moderniselife/deskling/case/renders/back_3q.png

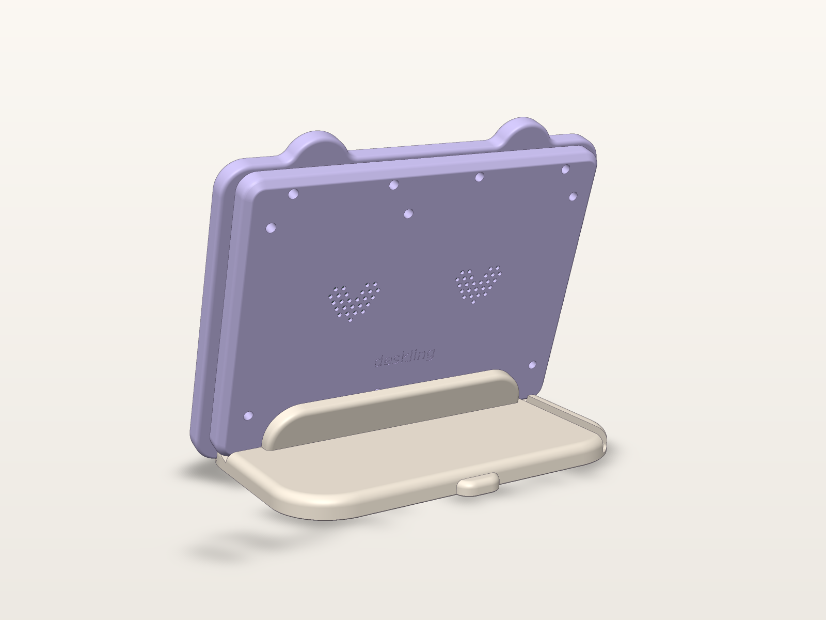
case/renders/back_3q.png
