moderniselife/deskling/case/renders/front.png

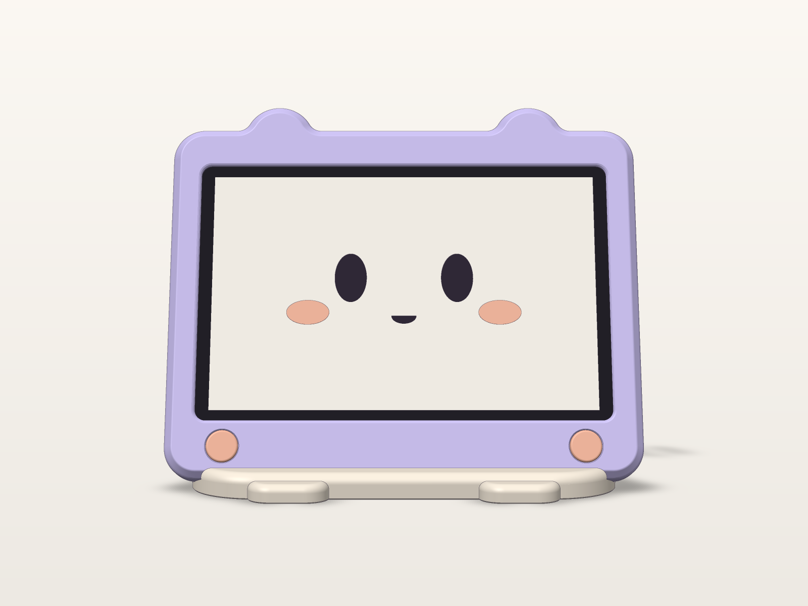
case/renders/front.png
