moderniselife/deskling/case/renders/section_side.png

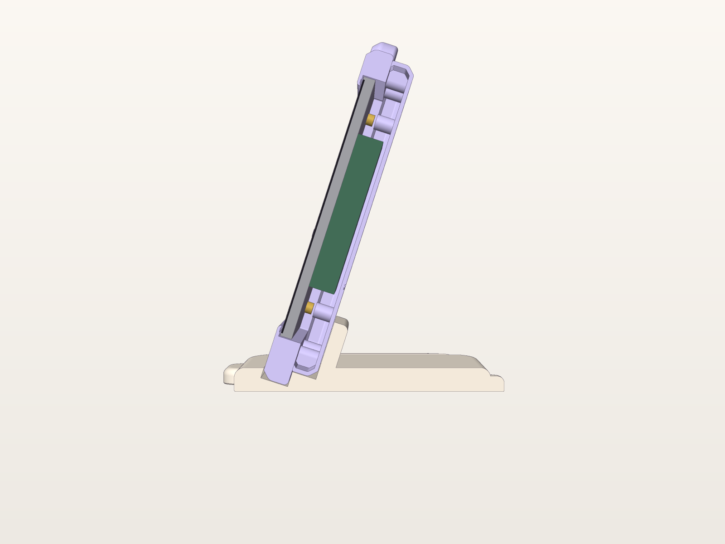
case/renders/section_side.png
