moderniselife/deskling/case/renders/stand.png

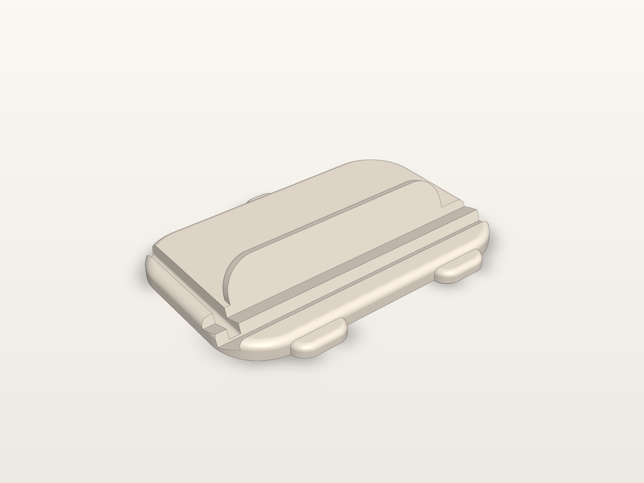
case/renders/stand.png
