moderniselife/deskling/case/renders/stand_underside.png

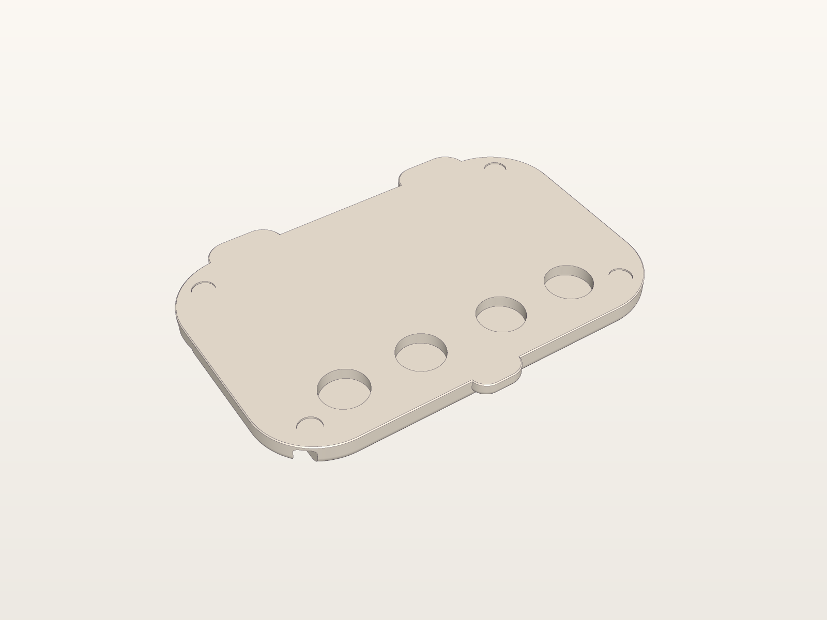
case/renders/stand_underside.png
