moderniselife/deskling/docs/media/home_done.gif

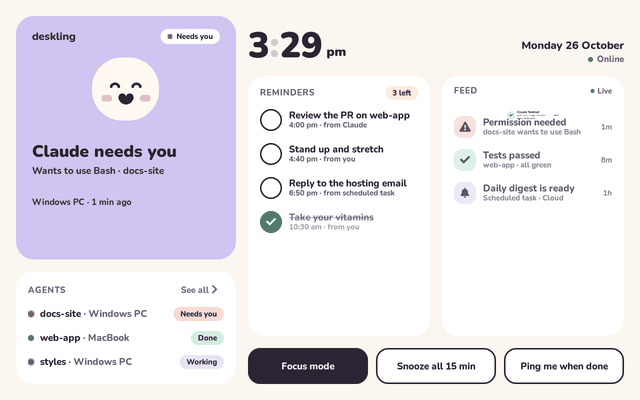
docs/media/home_done.gif
