moderniselife/deskling/docs/media/reminder.png

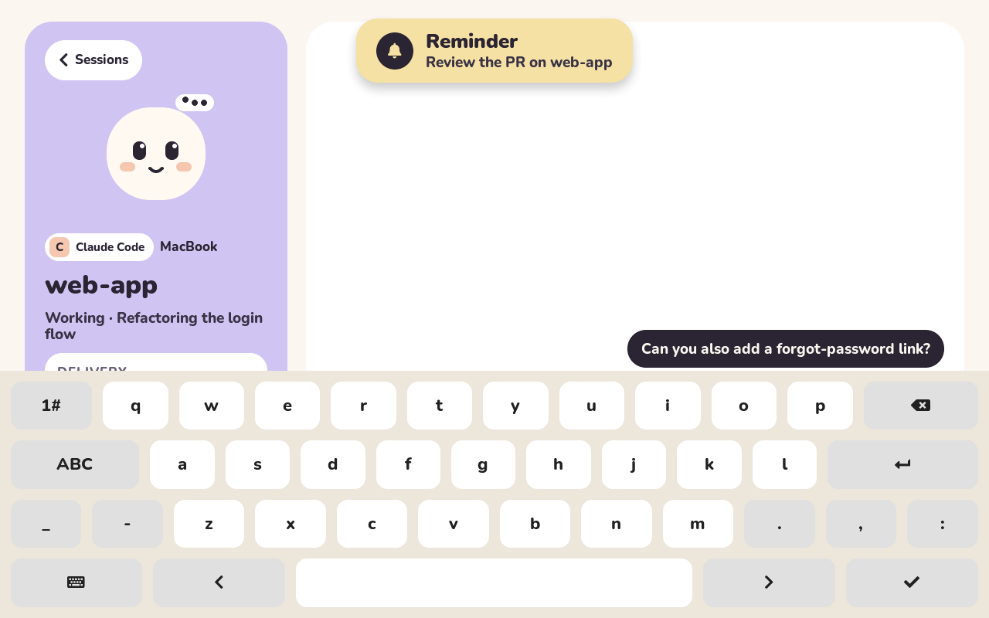
docs/media/reminder.png
