moderniselife/deskling/case/step/deskling_assembly.step

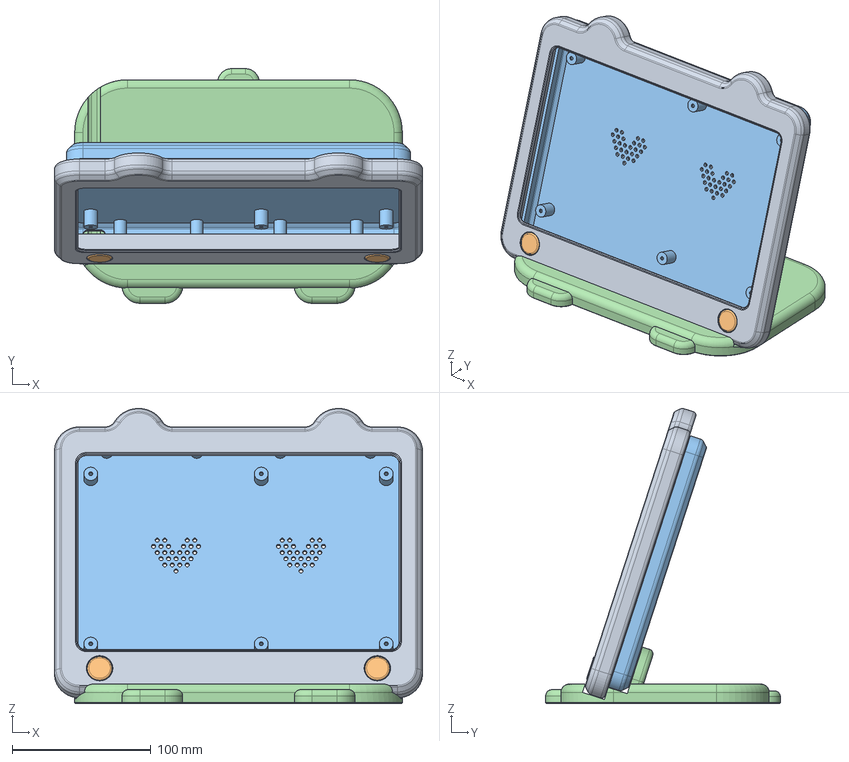
[picture p22: CAD file, 2026-10-26]
case/step/deskling_assembly.step
265.0 x 169.0 x 212.5 mm
