moderniselife/deskling/case/step/stand.step

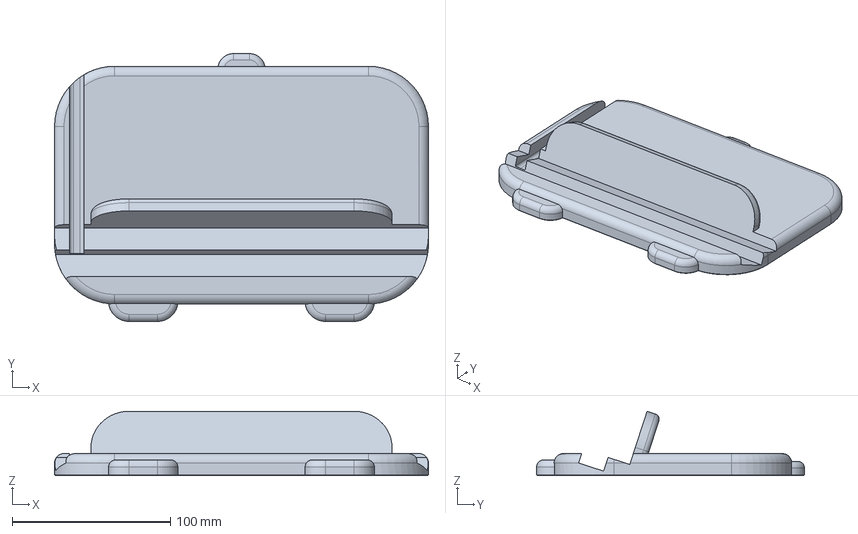
[picture p23: CAD file, 2026-10-26]
case/step/stand.step
236.0 x 169.0 x 40.7 mm
