moderniselife/deskling/case/step/bezel_right.step

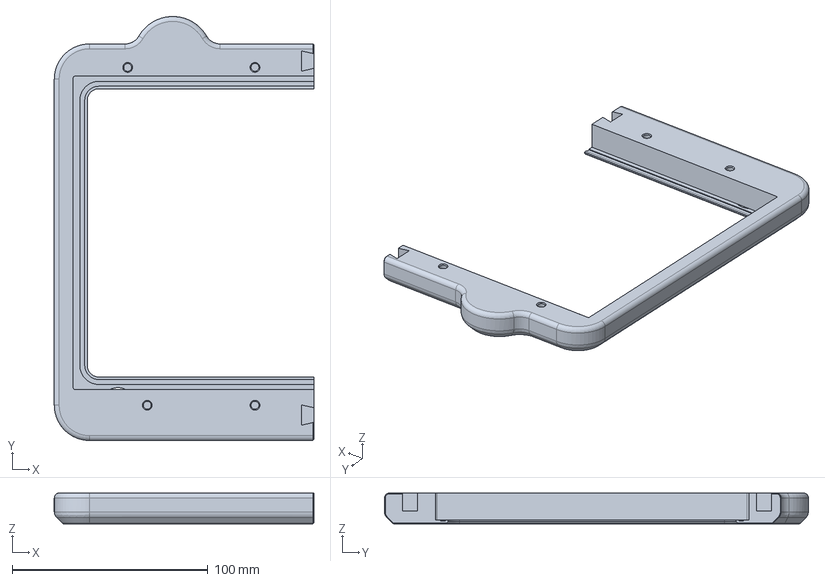
[picture p24: CAD file, 2026-10-26]
case/step/bezel_right.step
132.5 x 216.5 x 15.8 mm
