moderniselife/deskling/case/step/bezel_left.step

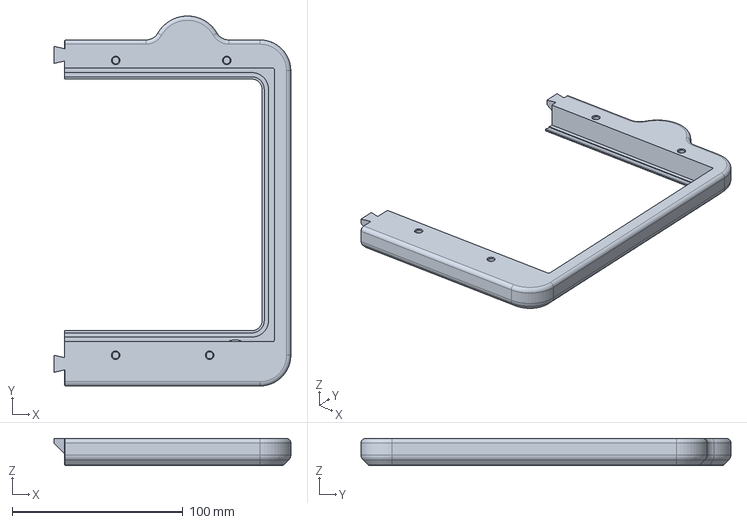
[picture p25: CAD file, 2026-10-26]
case/step/bezel_left.step
138.5 x 216.5 x 15.8 mm
