moderniselife/deskling/case/step/cheek_insert.step

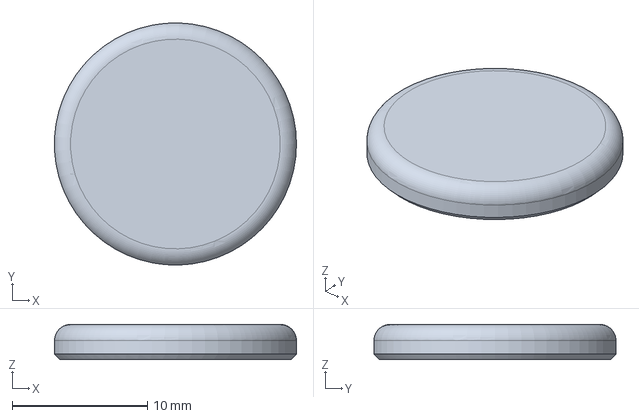
[picture p26: CAD file, 2026-10-26]
case/step/cheek_insert.step
17.9 x 17.9 x 2.60 mm
