moderniselife/deskling/case/step/bezel_onepiece.step

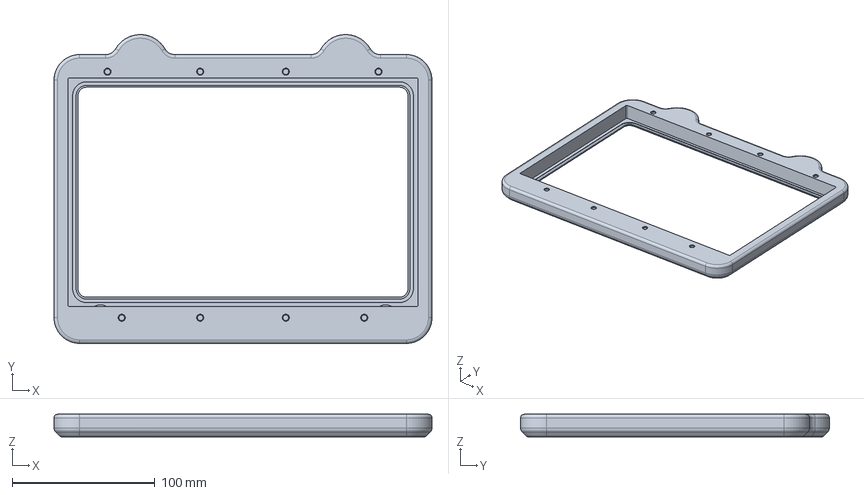
[picture p27: CAD file, 2026-10-26]
case/step/bezel_onepiece.step
265.0 x 216.5 x 15.8 mm
