moderniselife/deskling/case/step/back_cover.step

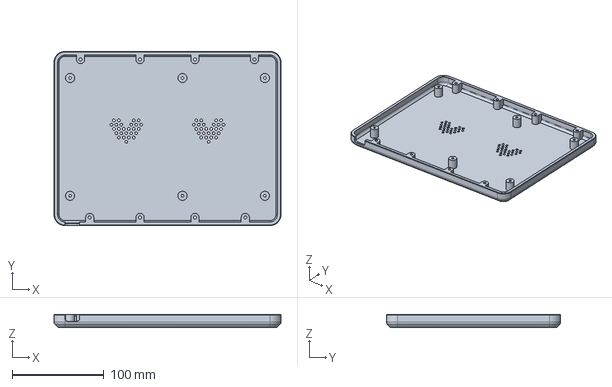
[picture p28: CAD file, 2026-10-26]
case/step/back_cover.step
248.0 x 190.3 x 14.4 mm
