moderniselife/deskling/case/step/fit_test_template.step

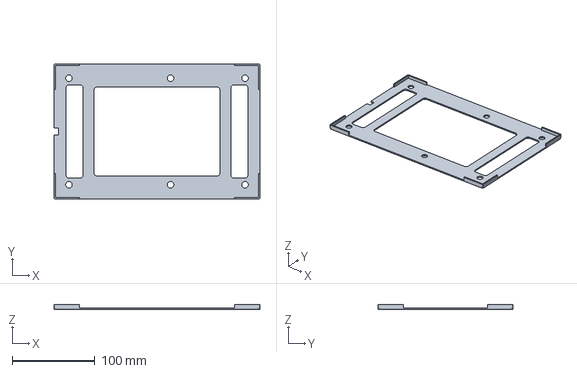
[picture p29: CAD file, 2026-10-26]
case/step/fit_test_template.step
248.8 x 163.2 x 6.00 mm
