moderniselife/deskling/(list of files, cad)

Other CAD files:
case/stl/back_cover.stl
case/stl/bezel_left.stl
case/stl/bezel_onepiece.stl
case/stl/bezel_right.stl
case/stl/cheek_insert.stl
case/stl/fit_test_template.stl
case/stl/stand.stl
