moderniselife/deskling/case/renders/bezel_split_print.png

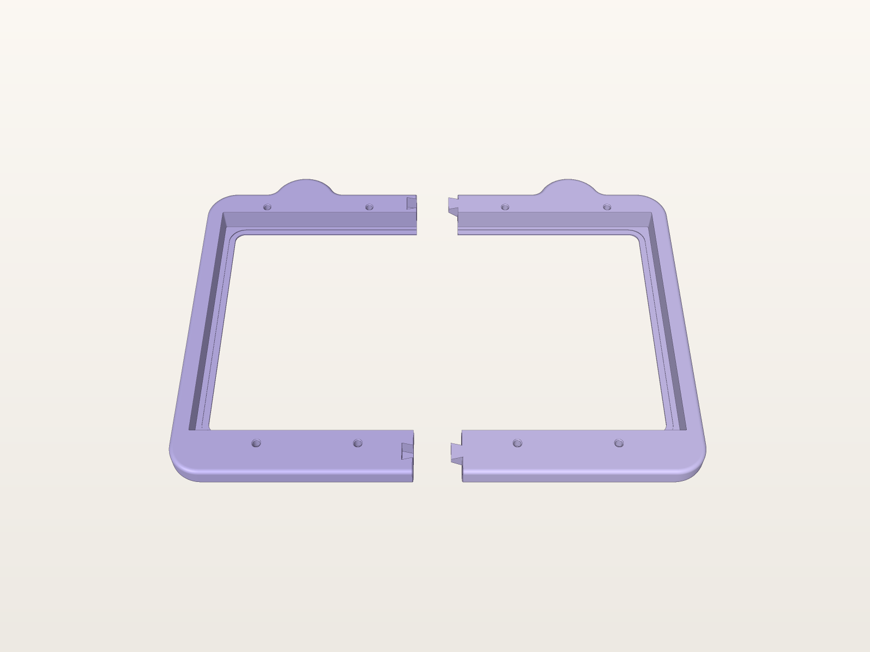
case/renders/bezel_split_print.png
