moderniselife/deskling/firmware/main/board/board.c

#include "board.h"

#include "driver/gpio.h"
#include "driver/i2c_master.h"
#include "driver/ledc.h"
#include "esp_check.h"
#include "esp_heap_caps.h"
#include "esp_timer.h"
#include "esp_lcd_mipi_dsi.h"
#include "esp_lcd_panel_io.h"
#include "esp_lcd_panel_ops.h"
#include "esp_ldo_regulator.h"
#include "esp_log.h"
#include "esp_lvgl_port.h"
#include "gsl3680.h"
#include "jd9365_init.h"
#include "settings.h"
#include "sdkconfig.h"

static const char *TAG = "board";

// Kconfig leaves disabled booleans undefined, so turn them into 0/1.
#ifdef CONFIG_DESKLING_LCD_V2
#define LCD_IS_V2 1
#else
#define LCD_IS_V2 0
#endif
#ifdef CONFIG_DESKLING_TOUCH_SWAP_XY
#define TOUCH_SWAP_XY 1
#else
#define TOUCH_SWAP_XY 0
#endif
#ifdef CONFIG_DESKLING_TOUCH_MIRROR_X
#define TOUCH_MIRROR_X 1
#else
#define TOUCH_MIRROR_X 0
#endif
#ifdef CONFIG_DESKLING_TOUCH_MIRROR_Y
#define TOUCH_MIRROR_Y 1
#else
#define TOUCH_MIRROR_Y 0
#endif
// The picture's way up: turned around (270) is right way up in the case. board_init's argument,
// changed later with board_set_rotate_180.
static bool s_rotate_180 = true;

#define BL_TIMER LEDC_TIMER_1
#define BL_CHANNEL LEDC_CHANNEL_1

static void backlight_init(void)
{
    const ledc_timer_config_t timer = {
        .speed_mode = LEDC_LOW_SPEED_MODE,
        .duty_resolution = LEDC_TIMER_10_BIT,
        .timer_num = BL_TIMER,
        .freq_hz = 20000,
        .clk_cfg = LEDC_AUTO_CLK,
    };
    ESP_ERROR_CHECK(ledc_timer_config(&timer));
    const ledc_channel_config_t ch = {
        .gpio_num = BOARD_LCD_BL_GPIO,
        .speed_mode = LEDC_LOW_SPEED_MODE,
        .channel = BL_CHANNEL,
        .timer_sel = BL_TIMER,
        .duty = 0,
    };
    ESP_ERROR_CHECK(ledc_channel_config(&ch));
}

void board_set_backlight(uint8_t percent)
{
    if (percent > 100) percent = 100;
    // Scale the UI's 0..100 (100 = day, 25 = night) by the saved daytime brightness.
    uint32_t duty = (uint32_t)percent * settings()->brightness * 1023 / 10000;
    ledc_set_duty(LEDC_LOW_SPEED_MODE, BL_CHANNEL, duty);
    ledc_update_duty(LEDC_LOW_SPEED_MODE, BL_CHANNEL);
}

static esp_err_t panel_init(esp_lcd_panel_io_handle_t *out_io, esp_lcd_panel_handle_t *out_panel)
{
    // The MIPI D-PHY is powered from the on-chip LDO.
    static esp_ldo_channel_handle_t ldo;
    const esp_ldo_channel_config_t ldo_cfg = {.chan_id = BOARD_MIPI_PHY_LDO_CHAN, .voltage_mv = BOARD_MIPI_PHY_LDO_MV};
    ESP_RETURN_ON_ERROR(esp_ldo_acquire_channel(&ldo_cfg, &ldo), TAG, "MIPI PHY LDO");

    esp_lcd_dsi_bus_handle_t bus;
    const esp_lcd_dsi_bus_config_t bus_cfg = JD9365_PANEL_BUS_DSI_2CH_CONFIG();
    ESP_RETURN_ON_ERROR(esp_lcd_new_dsi_bus(&bus_cfg, &bus), TAG, "DSI bus");

    const esp_lcd_dbi_io_config_t dbi_cfg = JD9365_PANEL_IO_DBI_CONFIG();
    ESP_RETURN_ON_ERROR(esp_lcd_new_panel_io_dbi(bus, &dbi_cfg, out_io), TAG, "DBI IO");

    esp_lcd_dpi_panel_config_t dpi = JD9365_800_1280_PANEL_60HZ_DPI_CONFIG_CF(LCD_COLOR_FMT_RGB565);
#if CONFIG_DESKLING_LCD_V2
    dpi.dpi_clock_freq_mhz = 70;
    dpi.video_timing.vsync_back_porch = 4;
    dpi.video_timing.vsync_pulse_width = 10;
    dpi.video_timing.vsync_front_porch = 30;
#else
    dpi.dpi_clock_freq_mhz = 60;
    dpi.video_timing.vsync_back_porch = 8;
    dpi.video_timing.vsync_pulse_width = 4;
    dpi.video_timing.vsync_front_porch = 20;
#endif
    dpi.num_fbs = 1;

    jd9365_vendor_config_t vendor = {
        .init_cmds = s_lcd_init_cmds,
        .init_cmds_size = sizeof(s_lcd_init_cmds) / sizeof(s_lcd_init_cmds[0]),
        .mipi_config = {.dsi_bus = bus, .dpi_config = &dpi, .lane_num = 2},
    };
    const esp_lcd_panel_dev_config_t dev = {
        .reset_gpio_num = BOARD_LCD_RST_GPIO,
        .rgb_ele_order = LCD_RGB_ELEMENT_ORDER_RGB,
        .bits_per_pixel = 16,
        .vendor_config = &vendor,
    };
    ESP_RETURN_ON_ERROR(esp_lcd_new_panel_jd9365(*out_io, &dev, out_panel), TAG, "JD9365 panel");
    ESP_RETURN_ON_ERROR(esp_lcd_panel_reset(*out_panel), TAG, "panel reset");
    ESP_RETURN_ON_ERROR(esp_lcd_panel_init(*out_panel), TAG, "panel init");
    esp_lcd_panel_disp_on_off(*out_panel, true);
    ESP_LOGI(TAG, "panel up (LCD %s)", LCD_IS_V2 ? "V2" : "V1");
    return ESP_OK;
}


// ------------------------------------------------------------ frame timing
// How long each redraw takes on the real hardware, logged every 5 s while things move and
// shown on the setup page, so slow screens can be measured instead of guessed at.
static struct {
    int64_t t0, flush_t0, wait_t0;
    bool rendered;
    uint32_t frames;
    uint64_t sum_us, flush_us, wait_us, px;
    uint32_t worst_us;
    board_display_stats_t last;
} s_perf;

static void perf_event(lv_event_t *e)
{
    switch (lv_event_get_code(e)) {
    case LV_EVENT_REFR_START:
        s_perf.t0 = esp_timer_get_time();
        s_perf.rendered = false;
        break;
    case LV_EVENT_RENDER_START:
        s_perf.rendered = true;
        break;
    case LV_EVENT_FLUSH_START: {
        const lv_area_t *a = lv_event_get_param(e);
        if (a) s_perf.px += lv_area_get_size(a);
        s_perf.flush_t0 = esp_timer_get_time();
        break;
    }
    case LV_EVENT_FLUSH_FINISH:
        s_perf.flush_us += esp_timer_get_time() - s_perf.flush_t0;
        break;
    case LV_EVENT_FLUSH_WAIT_START:
        s_perf.wait_t0 = esp_timer_get_time();
        break;
    case LV_EVENT_FLUSH_WAIT_FINISH:
        s_perf.wait_us += esp_timer_get_time() - s_perf.wait_t0;
        break;
    case LV_EVENT_REFR_READY:
        if (s_perf.rendered) {
            uint32_t us = (uint32_t)(esp_timer_get_time() - s_perf.t0);
            s_perf.frames++;
            s_perf.sum_us += us;
            if (us > s_perf.worst_us) s_perf.worst_us = us;
        }
        break;
    default:
        break;
    }
}

static void perf_report(lv_timer_t *t)
{
    (void)t;
    if (!s_perf.frames) return;
    s_perf.last.frames = s_perf.frames;
    s_perf.last.avg_ms = (float)s_perf.sum_us / s_perf.frames / 1000.0f;
    s_perf.last.worst_ms = s_perf.worst_us / 1000.0f;
    s_perf.last.busy_pct = (uint8_t)(s_perf.sum_us / 50000); // of 5 s
    // Where the time goes: rotating each band and handing it to DMA2D (flush), waiting for the
    // copy into the framebuffer to finish (wait), and LVGL drawing (the rest).
    s_perf.last.flush_ms = (float)s_perf.flush_us / s_perf.frames / 1000.0f;
    s_perf.last.wait_ms = (float)s_perf.wait_us / s_perf.frames / 1000.0f;
    s_perf.last.draw_ms = s_perf.last.avg_ms - s_perf.last.flush_ms - s_perf.last.wait_ms;
    s_perf.last.kpx = (uint32_t)(s_perf.px / s_perf.frames / 1000);
    ESP_LOGI(TAG, "display: %u redraws in 5 s, %.1f ms each (draw %.1f, rotate %.1f, copy wait %.1f) for %uk px, worst %.1f ms, busy %u%%",
             (unsigned)s_perf.frames, s_perf.last.avg_ms, s_perf.last.draw_ms, s_perf.last.flush_ms, s_perf.last.wait_ms,
             (unsigned)s_perf.last.kpx, s_perf.last.worst_ms, s_perf.last.busy_pct);
    s_perf.frames = 0;
    s_perf.sum_us = s_perf.flush_us = s_perf.wait_us = s_perf.px = 0;
    s_perf.worst_us = 0;
}

board_display_stats_t board_display_stats(void)
{
    return s_perf.last;
}

static void perf_init(lv_display_t *disp)
{
    lv_display_add_event_cb(disp, perf_event, LV_EVENT_REFR_START, NULL);
    lv_display_add_event_cb(disp, perf_event, LV_EVENT_RENDER_START, NULL);
    lv_display_add_event_cb(disp, perf_event, LV_EVENT_REFR_READY, NULL);
    lv_display_add_event_cb(disp, perf_event, LV_EVENT_FLUSH_START, NULL);
    lv_display_add_event_cb(disp, perf_event, LV_EVENT_FLUSH_FINISH, NULL);
    lv_display_add_event_cb(disp, perf_event, LV_EVENT_FLUSH_WAIT_START, NULL);
    lv_display_add_event_cb(disp, perf_event, LV_EVENT_FLUSH_WAIT_FINISH, NULL);
    lv_timer_create(perf_report, 5000, NULL);
}

static i2c_master_bus_handle_t s_i2c; // shared by touch and the audio codec

i2c_master_bus_handle_t board_i2c_bus(void)
{
    return s_i2c;
}

static esp_lcd_touch_handle_t touch_init(void)
{
    i2c_master_bus_handle_t i2c;
    const i2c_master_bus_config_t bus_cfg = {
        .i2c_port = -1,
        .sda_io_num = BOARD_TOUCH_SDA_GPIO,
        .scl_io_num = BOARD_TOUCH_SCL_GPIO,
        .clk_source = I2C_CLK_SRC_DEFAULT,
        .glitch_ignore_cnt = 7,
        .flags.enable_internal_pullup = true,
    };
    if (i2c_new_master_bus(&bus_cfg, &i2c) != ESP_OK) {
        ESP_LOGE(TAG, "I2C bus failed: no touch");
        return NULL;
    }
    s_i2c = i2c;
    esp_lcd_panel_io_handle_t io;
    const esp_lcd_panel_io_i2c_config_t io_cfg = {
        .dev_addr = GSL3680_I2C_ADDRESS,
        .scl_speed_hz = 400000, // must be set: 0 makes every transaction fail on IDF 5.4+
        .control_phase_bytes = 1,
        .lcd_cmd_bits = 8,
        .lcd_param_bits = 8,
        .flags.disable_control_phase = 1,
        .transaction_timeout_ms = 100,
    };
    if (esp_lcd_new_panel_io_i2c(i2c, &io_cfg, &io) != ESP_OK) return NULL;

    const esp_lcd_touch_config_t cfg = {
        .x_max = BOARD_LCD_H_RES,
        .y_max = BOARD_LCD_V_RES,
        .rst_gpio_num = BOARD_TOUCH_RST_GPIO,
        // Polled, not interrupt-driven: with an INT pin, esp_lvgl_port only reads the panel after
        // an interrupt, and the GSL3680's INT edge isn't reliable across board batches. Polling
        // costs one small I2C read per LVGL input tick (~30 ms).
        .int_gpio_num = GPIO_NUM_NC,
        .levels = {.reset = 0, .interrupt = 0},
        .flags =
            {
                .swap_xy = TOUCH_SWAP_XY,
                .mirror_x = TOUCH_MIRROR_X,
                .mirror_y = TOUCH_MIRROR_Y,
            },
    };
    esp_lcd_touch_handle_t tp = NULL;
    if (dk_gsl3680_new(io, &cfg, &tp) != ESP_OK) return NULL;
    dk_gsl3680_set_mapping(NULL, s_rotate_180 ? 270 : 90);
    return tp;
}


// ------------------------------------------------------------- display
#if CONFIG_DESKLING_FAST_DISPLAY
// LVGL draws the 1280x800 landscape UI in horizontal bands. Each finished band is handed to the
// PPA, which rotates it straight into its place in the panel's portrait framebuffer in the
// background while LVGL draws the next band into the other buffer. No intermediate copy, and
// the CPU never waits on the rotation unless it gets a whole band ahead.
#include "driver/ppa.h"
#include "freertos/semphr.h"

static struct {
    ppa_client_handle_t srm;
    SemaphoreHandle_t done;
    void *fb;
    size_t fb_size;
    bool busy;
} s_disp;

static bool IRAM_ATTR band_done(ppa_client_handle_t client, ppa_event_data_t *ev, void *user)
{
    (void)client;
    (void)ev;
    (void)user;
    BaseType_t woken = pdFALSE;
    xSemaphoreGiveFromISR(s_disp.done, &woken);
    return woken == pdTRUE;
}

static void band_flush(lv_display_t *d, const lv_area_t *area, uint8_t *px)
{
    const int32_t w = lv_area_get_width(area), h = lv_area_get_height(area);
    const int32_t hres = lv_display_get_horizontal_resolution(d); // landscape width (1280)
    const int32_t vres = lv_display_get_vertical_resolution(d);
    lv_display_rotation_t rot = lv_display_get_rotation(d);
    ppa_srm_rotation_angle_t angle = PPA_SRM_ROTATION_ANGLE_0;
    int32_t ox = area->x1, oy = area->y1;
    // Same mapping as esp_lvgl_port's PPA rotation (landscape band -> portrait framebuffer).
    if (rot == LV_DISPLAY_ROTATION_90) {
        angle = PPA_SRM_ROTATION_ANGLE_90;
        ox = area->y1;
        oy = hres - area->x2 - 1;
    } else if (rot == LV_DISPLAY_ROTATION_270) {
        angle = PPA_SRM_ROTATION_ANGLE_270;
        ox = vres - area->y2 - 1;
        oy = area->x1;
    } else if (rot == LV_DISPLAY_ROTATION_180) {
        angle = PPA_SRM_ROTATION_ANGLE_180;
        ox = hres - area->x2 - 1;
        oy = vres - area->y2 - 1;
    }
    ppa_srm_oper_config_t op = {
        .in = {.buffer = px, .pic_w = w, .pic_h = h, .block_w = w, .block_h = h, .srm_cm = PPA_SRM_COLOR_MODE_RGB565},
        .out = {.buffer = s_disp.fb, .buffer_size = s_disp.fb_size, .pic_w = BOARD_LCD_H_RES, .pic_h = BOARD_LCD_V_RES,
                .block_offset_x = ox, .block_offset_y = oy, .srm_cm = PPA_SRM_COLOR_MODE_RGB565},
        .rotation_angle = angle,
        .scale_x = 1.0f,
        .scale_y = 1.0f,
        .mode = PPA_TRANS_MODE_NON_BLOCKING,
    };
    s_disp.busy = true;
    esp_err_t err = ppa_do_scale_rotate_mirror(s_disp.srm, &op);
    if (err != ESP_OK) {
        static bool warned;
        if (!warned) ESP_LOGE(TAG, "band rotate failed: %s", esp_err_to_name(err));
        warned = true;
        s_disp.busy = false;
        lv_display_flush_ready(d);
    }
}

/** LVGL calls this before reusing a buffer: sleep until the PPA has finished with it. */
static void band_wait(lv_display_t *d)
{
    (void)d;
    if (!s_disp.busy) return;
    // A band takes well under a millisecond; never let a lost completion hang the whole UI.
    if (xSemaphoreTake(s_disp.done, pdMS_TO_TICKS(100)) != pdTRUE) {
        static uint32_t misses;
        if (misses++ < 5) ESP_LOGE(TAG, "band rotate didn't finish in 100 ms");
    }
    s_disp.busy = false;
}

static lv_display_t *display_init(esp_lcd_panel_handle_t panel)
{
    ESP_ERROR_CHECK(esp_lcd_dpi_panel_get_frame_buffer(panel, 1, &s_disp.fb));
    s_disp.fb_size = BOARD_LCD_H_RES * BOARD_LCD_V_RES * 2;
    s_disp.done = xSemaphoreCreateBinary();
    ppa_client_config_t cc = {.oper_type = PPA_OPERATION_SRM, .max_pending_trans_num = 1};
    ESP_ERROR_CHECK(ppa_register_client(&cc, &s_disp.srm));
    ppa_event_callbacks_t cbs = {.on_trans_done = band_done};
    ESP_ERROR_CHECK(ppa_client_register_event_callbacks(s_disp.srm, &cbs));

    // Bands in internal RAM draw much faster than in PSRAM (which the panel is also reading the
    // framebuffer out of, 60 times a second). Use it when there's room for both bands and still
    // plenty left for Wi-Fi and everything else; otherwise fall back to PSRAM.
    // Wi-Fi (through the C6), TLS and the web server all need internal RAM too, later on.
    const size_t margin = 300 * 1024;
    size_t lines = 100, bytes = 0;
    void *b1 = NULL, *b2 = NULL;
    bool internal = false;
    for (size_t l = 32; l >= 16 && !internal; l /= 2) {
        size_t n = (size_t)BOARD_LCD_V_RES * l * 2; // landscape rows are 1280 px wide
        if (heap_caps_get_largest_free_block(MALLOC_CAP_INTERNAL | MALLOC_CAP_DMA) < n + 1024 ||
            heap_caps_get_free_size(MALLOC_CAP_INTERNAL | MALLOC_CAP_DMA) < 2 * n + margin)
            continue;
        b1 = heap_caps_aligned_alloc(64, n, MALLOC_CAP_INTERNAL | MALLOC_CAP_DMA);
        b2 = heap_caps_aligned_alloc(64, n, MALLOC_CAP_INTERNAL | MALLOC_CAP_DMA);
        if (b1 && b2) {
            internal = true;
            lines = l;
            bytes = n;
        } else {
            heap_caps_free(b1);
            heap_caps_free(b2);
            b1 = b2 = NULL;
        }
    }
    if (!internal) {
        bytes = (size_t)BOARD_LCD_V_RES * lines * 2;
        b1 = heap_caps_aligned_alloc(64, bytes, MALLOC_CAP_SPIRAM);
        b2 = heap_caps_aligned_alloc(64, bytes, MALLOC_CAP_SPIRAM);
        assert(b1 && b2);
    }
    s_perf.last.internal_bands = internal;
    s_perf.last.band_lines = lines;
    ESP_LOGI(TAG, "render bands: %u lines in %s, PPA straight into the framebuffer (internal free %u KB)", (unsigned)lines,
             internal ? "internal RAM" : "PSRAM", (unsigned)(heap_caps_get_free_size(MALLOC_CAP_INTERNAL) / 1024));

    lvgl_port_lock(0);
    lv_display_t *disp = lv_display_create(BOARD_LCD_H_RES, BOARD_LCD_V_RES);
    lv_display_set_color_format(disp, LV_COLOR_FORMAT_RGB565);
    lv_display_set_buffers(disp, b1, b2, bytes, LV_DISPLAY_RENDER_MODE_PARTIAL);
    lv_display_set_flush_cb(disp, band_flush);
    lv_display_set_flush_wait_cb(disp, band_wait);
    lv_display_set_rotation(disp, s_rotate_180 ? LV_DISPLAY_ROTATION_270 : LV_DISPLAY_ROTATION_90);
    lvgl_port_unlock();
    return disp;
}


#endif // CONFIG_DESKLING_FAST_DISPLAY

/** The esp_lvgl_port path (PPA rotation into a band buffer, then DMA2D into the framebuffer). */
static lv_display_t *display_init_port(esp_lcd_panel_io_handle_t io, esp_lcd_panel_handle_t panel)
{
    size_t band_px = BOARD_LCD_H_RES * 160; // PSRAM fallback: 1280 x 100 lines
    bool internal = false;
    const size_t margin = 160 * 1024;
    for (size_t lines = 40; lines >= 20 && !internal; lines /= 2) {
        size_t px = BOARD_LCD_H_RES * (lines * BOARD_LCD_V_RES / BOARD_LCD_H_RES); // lines of the 1280-wide landscape
        size_t bytes = px * 2;
        size_t free_dma = heap_caps_get_free_size(MALLOC_CAP_INTERNAL | MALLOC_CAP_DMA);
        size_t largest = heap_caps_get_largest_free_block(MALLOC_CAP_INTERNAL | MALLOC_CAP_DMA);
        if (largest >= bytes + 1024 && free_dma >= 3 * bytes + margin) {
            band_px = px;
            internal = true;
        }
    }
    s_perf.last.internal_bands = internal;
    s_perf.last.band_lines = band_px / BOARD_LCD_V_RES;
    ESP_LOGI(TAG, "render bands: %u lines in %s (internal free %u KB)", (unsigned)(band_px / BOARD_LCD_V_RES),
             internal ? "internal RAM" : "PSRAM", (unsigned)(heap_caps_get_free_size(MALLOC_CAP_INTERNAL) / 1024));

    const lvgl_port_display_cfg_t disp_cfg = {
        .io_handle = io,
        .panel_handle = panel,
        .buffer_size = band_px,
        .double_buffer = true,
        .hres = BOARD_LCD_H_RES,
        .vres = BOARD_LCD_V_RES,
        .color_format = LV_COLOR_FORMAT_RGB565,
        .flags =
            {
                .buff_dma = internal,
                .buff_spiram = !internal,
                .sw_rotate = true, // done by the P4's PPA engine
            },
    };
    const lvgl_port_display_dsi_cfg_t dsi_cfg = {.flags = {.avoid_tearing = false}};
    lv_display_t *disp = lvgl_port_add_disp_dsi(&disp_cfg, &dsi_cfg);
    assert(disp);
    // Copy rotated bands into the framebuffer with DMA2D instead of a CPU memcpy.
    if (esp_lcd_dpi_panel_enable_dma2d(panel) != ESP_OK) ESP_LOGW(TAG, "DMA2D unavailable, copying bands with the CPU");
    lvgl_port_lock(0);
    lv_display_set_rotation(disp, s_rotate_180 ? LV_DISPLAY_ROTATION_270 : LV_DISPLAY_ROTATION_90);
    lvgl_port_unlock();
    return disp;
}

static lv_display_t *s_display;

void board_set_rotate_180(bool on)
{
    s_rotate_180 = on;
    dk_gsl3680_set_rotation(on ? 270 : 90); // touch follows the picture
    if (!s_display) return;
    lvgl_port_lock(0);
    lv_display_set_rotation(s_display, on ? LV_DISPLAY_ROTATION_270 : LV_DISPLAY_ROTATION_90);
    lv_obj_invalidate(lv_screen_active());
    lvgl_port_unlock();
}

lv_display_t *board_init(bool rotate_180)
{
    s_rotate_180 = rotate_180;
    backlight_init();
    board_set_backlight(0);

    esp_lcd_panel_io_handle_t io;
    esp_lcd_panel_handle_t panel;
    ESP_ERROR_CHECK(panel_init(&io, &panel));

    lvgl_port_cfg_t port_cfg = ESP_LVGL_PORT_INIT_CONFIG();
    port_cfg.task_priority = 4;
    port_cfg.task_stack = 16 * 1024;
    port_cfg.task_affinity = 1;
    port_cfg.timer_period_ms = 5;
    ESP_ERROR_CHECK(lvgl_port_init(&port_cfg));

#if CONFIG_DESKLING_FAST_DISPLAY
    lv_display_t *disp = display_init(panel);
    assert(disp);
#else
    lv_display_t *disp = display_init_port(io, panel);
#endif

    lvgl_port_lock(0);
    perf_init(disp);
    lvgl_port_unlock();

    esp_lcd_touch_handle_t tp = touch_init();
    if (tp) {
        const lvgl_port_touch_cfg_t touch_cfg = {.disp = disp, .handle = tp};
        lvgl_port_add_touch(&touch_cfg);
    }
    s_display = disp;
    return disp;
}
