moderniselife/deskling/(commit log)

2026-10-26 Add relay worker and Claude Code hooks plugin
2026-10-26 Add parametric 3D-printable case
    [back_cover.step, back_cover.stl, bezel_left.step, bezel_left.stl, bezel_onepiece.step, bezel_onepiece.stl, bezel_right.step, bezel_right.stl]
2026-10-26 Firmware: animated LVGL UI, board bring-up, touch fix, Wi-Fi + relay client, host simulator
    [partitions.csv]
2026-10-26 Relay setup and flash pages, release script, setup guide
2026-10-26 Landing page, browser installer and firmware update server for deskling.mojolayers.com
2026-10-26 Docs for the website, sounds and update server; relay installer uses the update server
2026-10-26 Plugin: relay URL and token can come from ~/.deskling/config when the app has no settings UI
2026-10-26 Installer: Show the log button (restarts the board and streams its boot log)
2026-10-26 Installer: restart the board with the boot pin released after flashing
2026-10-26 Touch: poll the GSL3680 instead of waiting for an interrupt that never fired; log presses
2026-10-26 Device page: accept long browser headers and show connection errors; installer can install a local file
2026-10-26 Boot animation; touch calibration (five taps, saved, redo from Settings or the web page); touch reads mapped through the calibration
2026-10-26 Explain relay failures and check local-name traffic
2026-10-26 Faster rendering, install screen, fix relay TLS
    [anim.c, anim.h, board.c, board.h, deskling.c, gestures.c, gsl3680.c]
2026-10-26 Notification banners, skip unchanged rebuilds, PPA straight to framebuffer
    [board.c, board.h, gestures.c, scr_chat.c, scr_home.c, scr_night.c, scr_sessions.c]
2026-10-26 Redesign the landing page, add brand tokens and guide
2026-10-26 Start sessions from Deskling: runner for your computers, cloud routines; channel permission relay
2026-10-26 Fix the crash when a chat picture arrives
    [images.c]
2026-10-26 Board page: stop polling with an old code after a restart; repeats don't count as guesses
2026-10-26 Remember the last crash and show it on the board's page; sim can replay a real snapshot
    [main.c]
2026-10-26 Board page stops answering: give the web server enough sockets
2026-10-26 Relay: keep the routine token out of /api/state
2026-10-26 Fix a crash when an open chat's session ends; OpenCode scenes in the simulator
    [scr_chat.c]
2026-10-26 Relay: ids like __proto__ can't touch shared objects; fuzz test; free ports in the OpenCode test
2026-10-26 Fixes from review: no chime while replies stream, ACP timeouts and clean ends, ordered uploads, background uploads on Windows
    [scr_new.c]
2026-10-26 Push notifications for /app: encrypted, signed by the relay, even with the page closed
2026-10-26 Screen right way up in the case by default, with a setting to turn it around
2026-10-26 Board: hand relay messages to the screen without blocking, incremental chat redraw, relay watchdog, one-line labels
2026-10-27 Quests: Mojo Desk, Linear and Jira tickets as a game on the board and in /app; relay heartbeat
2026-10-27 Board: LVGL memory in PSRAM when internal RAM runs low; mDNS priority up
2026-10-28 Board housekeeping: pause hidden-screen animations, let go of old chats, health on deskling.local, quiet fresh starts
